Accessibilita/USB-HID-Module-Hat/README.md

# USB-HID-Module-Hat
Raspberry Pi Hat that adds RS485 communication to Raspberry Pi 5 for interfacting with USB and Bluetooth HID Devices
