Accessibilita/USB-HID-Module-Hat/PCB/USB-HID-Module-Hat/USB-HID-Module-Hat.kicad_pcb

## KiCad design PCB/USB-HID-Module-Hat/USB-HID-Module-Hat.kicad_pcb (2024-09-03)

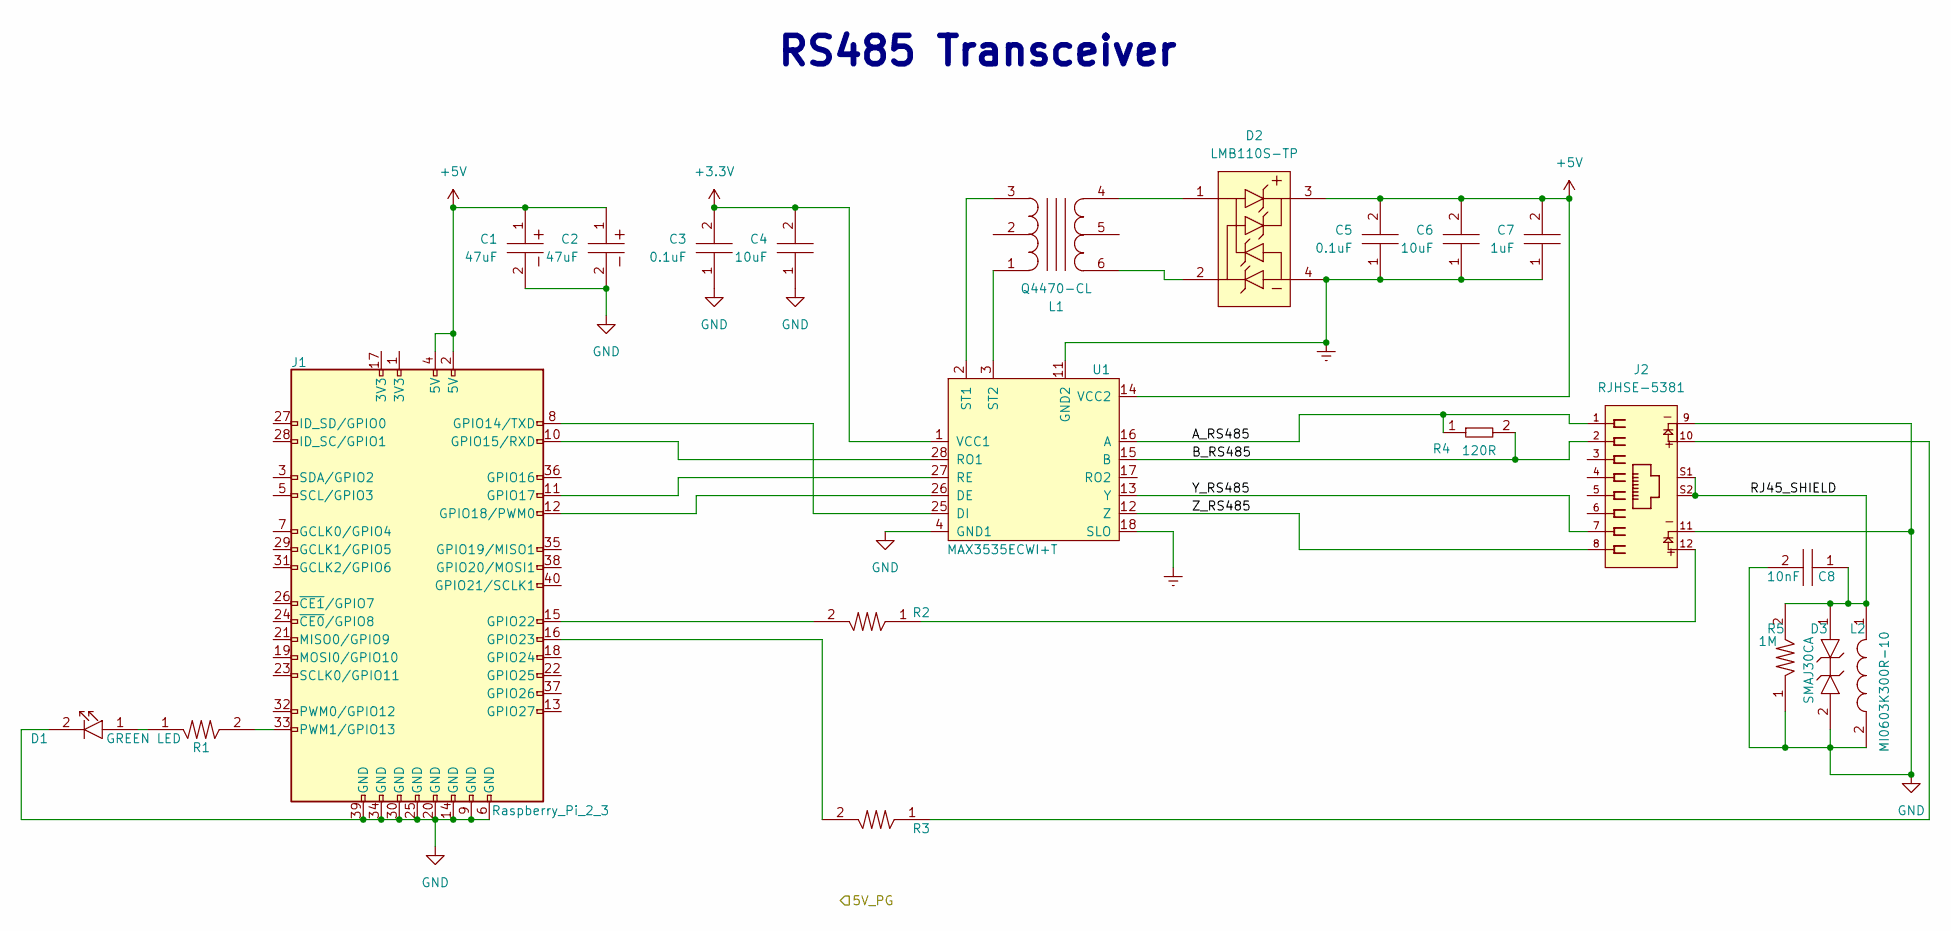
[picture p1: schematic RS485.kicad_sch]

Parts:
C1, C2: UCM1C470MCL1GS; Tolerance 20%; Voltage 16V; MFR# UCM1C470MCL1GS
C3, C5: CL10B104JB8NNNC; C0603; Tolerance 5%; Voltage 50V; MFR# CL10B104JB8NNNC
C4, C6: CGA5L3X5R1V106K160AB; C1206; Tolerance 10%; Voltage 35V; MFR# CGA5L3X5R1V106K160AB
C7: C1206C105K3RACAUTO; D_SOD-123; Tolerance 10%; Voltage 25V; MFR# C1206C105K3RACAUTO
C8: C0805C103KCRACAUTO; C0805; Tolerance 10%; Voltage 500V; MFR# C0805C103KCRACAUTO
D1: LTST-C194KGKT; LED0603; Tolerance *; Voltage 2.1V; MFR# LTST-C194KGKT
D2: LMB110S-TP; Tolerance *; Voltage 850 mV @ 500 mA; MFR# LMB110S-TP
D3: SMAJ30CA; Tolerance *; Voltage 30V Clamp; MFR# SMAJ30CA
J1: Raspberry_Pi_2_3; SULLINS_PPPC202LFBN-RC_RPi5
J2: RJHSE-5381; AMPHENOL_RJHSE-5381; Tolerance *; Voltage *; MFR# RJHSE-5381
L1: Q4470-CL; SO6_Q4470-CL_C-SIZE_COC; Tolerance *; Voltage 5V; MFR# Q4470-CL
L2: MI0603K300R-10; Tolerance *; Voltage *; MFR# MI0603K300R-10
R1, R2, R3: RC0603FR-07470RL; R0603; Tolerance 1%; Voltage *; MFR# RC0603FR-07470RL
R4: AC0402FR-07120RL; R0402; Tolerance 1%; Voltage *; MFR# AC0402FR-07120RL
R5: RC1206FR-071ML; R1206; Tolerance 1%; Voltage *; MFR# RC1206FR-071ML
U1: MAX3535ECWI+T; 21-0145_W28M&plus_9_MXM; Tolerance N/A; Voltage 3-5.5V; MFR# MAX3535ECWI+T

Connections:
+3.3V: C3.2, C4.2, U1.1 (VCC1); also elsewhere on the board
+5V: C1.1, C2.1, C5.2, C6.2, C7.2, D2.3, J1.2 (5V), J1.4 (5V), U1.14 (VCC2); also elsewhere on the board
/RS485/A_RS485: J2.1, R4.1, U1.16 (A)
/RS485/B_RS485: J2.2, R4.2, U1.15 (B)
/RS485/RJ45_SHIELD: C8.1, D3.1, J2.S1, J2.S2, L2.1, R5.2
/RS485/Y_RS485: J2.7, U1.13 (Y)
/RS485/Z_RS485: J2.8, U1.12 (Z)
Earth: C5.1, C6.1, C7.1, D2.4, U1.11 (GND2), U1.18 (SLO)
GND: C1.2, C2.2, C3.1, C4.1, C8.2, D1.2, D3.2, J1.6 (GND), J1.9 (GND), J1.14 (GND), J1.20 (GND), J1.25 (GND), J1.30 (GND), J1.34 (GND), J1.39 (GND), J2.9, J2.11, L2.2, R5.1, U1.4 (GND1); also elsewhere on the board
unnamed: D1.1, R1.1
unnamed: D2.1, L1.4
unnamed: D2.2, L1.6
unnamed: J1.8 (GPIO14/TXD), U1.25 (DI)
unnamed: J1.10 (GPIO15/RXD), U1.28 (RO1)
unnamed: J1.11 (GPIO17), U1.27 (RE)
unnamed: J1.12 (GPIO18/PWM0), U1.26 (DE)
unnamed: J1.15 (GPIO22), R2.2
unnamed: J1.16 (GPIO23), R3.2
unnamed: J1.33 (PWM1/GPIO13), R1.2
unnamed: J2.10, R3.1
unnamed: J2.12, R2.1
unnamed: L1.3, U1.2 (ST1)
unnamed: L1.1, U1.3 (ST2)

Notes on the sheet:
RS485 Transceiver

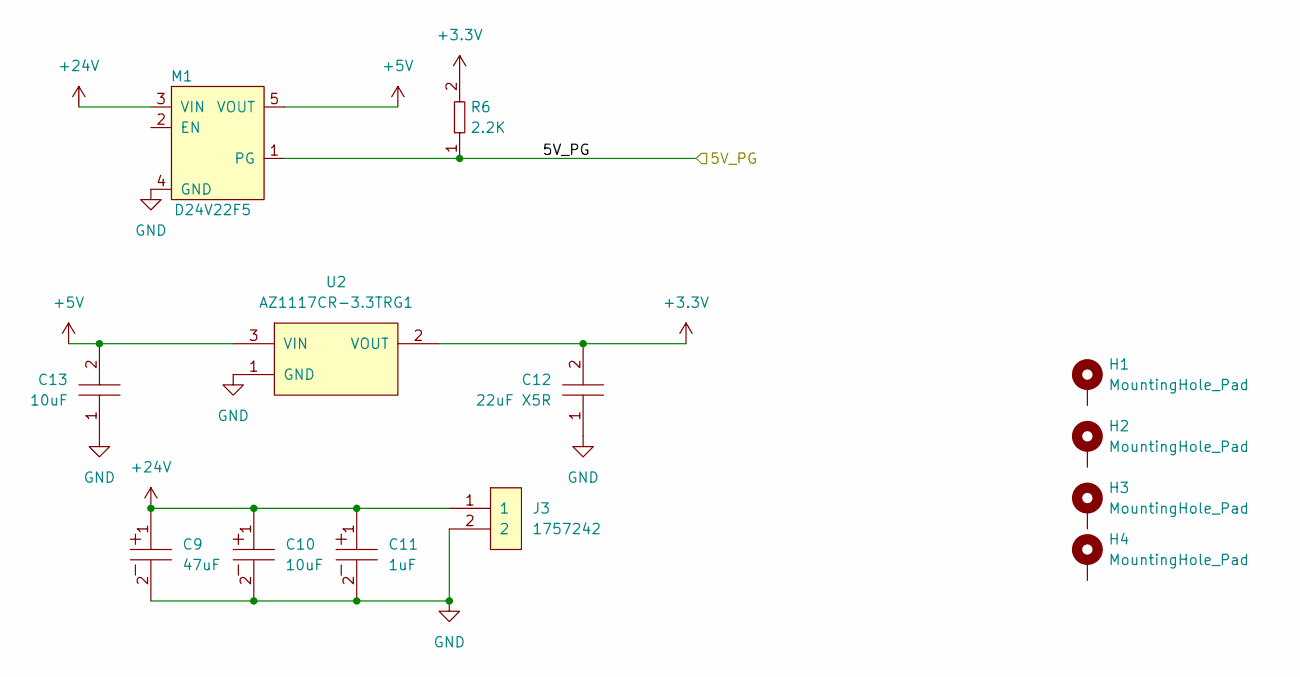
[picture p2: schematic Power.kicad_sch]

Parts:
C9: UUQ1H470MCL1GS; CP_Elec_8x10; Tolerance 20%; Voltage 50V; MFR# UUQ1H470MCL1GS
C10: UUQ1H100MCL1GB; CAP_UUQ_6P3X5P4_NCH; Tolerance 20%; Voltage 50V; MFR# UUQ1H100MCL1GB
C11: UUQ1H010MCL1GB; CAP_UUQ_4X5P4_NCH; Tolerance 20%; Voltage 50V; MFR# UUQ1H010MCL1GB
C12: GRM21BR61A226ME51L; C0805; Tolerance 20%; Voltage 10V; MFR# GRM21BR61A226ME51L
C13: GRT31CR61H106KE01L; C1206; Tolerance 10%; Voltage 50V; MFR# GRT31CR61H106KE01L
H1, H2, H3, H4: MountingHole_Pad; RPI_HAT_HOLE
J3: 1757242; PhoenixContact_MSTBA-G_02x5.08mm_Angled; Tolerance *; Voltage 300V; MFR# 1757242
M1: D24V22F5; D24V22F12; Tolerance N/A; Voltage 36V IN 5V OUT; MFR# D24V22F5
R6: RC0603FR-072K2L; R0603; Tolerance 1%; Voltage N/A; MFR# RC0603FR-072K2L
U2: AZ1117CR-3.3TRG1; SOT_89; Tolerance *; Voltage 15IN, 3V3 OUT; MFR# AZ1117CR-3.3TRG1

Connections:
+3.3V: C12.2, R6.2, U2.2 (VOUT); also elsewhere on the board
+5V: C13.2, M1.5 (VOUT), U2.3 (VIN); also elsewhere on the board
+24V: C9.1, C10.1, C11.1, J3.1, M1.3 (VIN)
/Power/5V_PG: M1.1 (PG), R6.1
GND: C9.2, C10.2, C11.2, C12.1, C13.1, J3.2, M1.4 (GND), U2.1 (GND); also elsewhere on the board

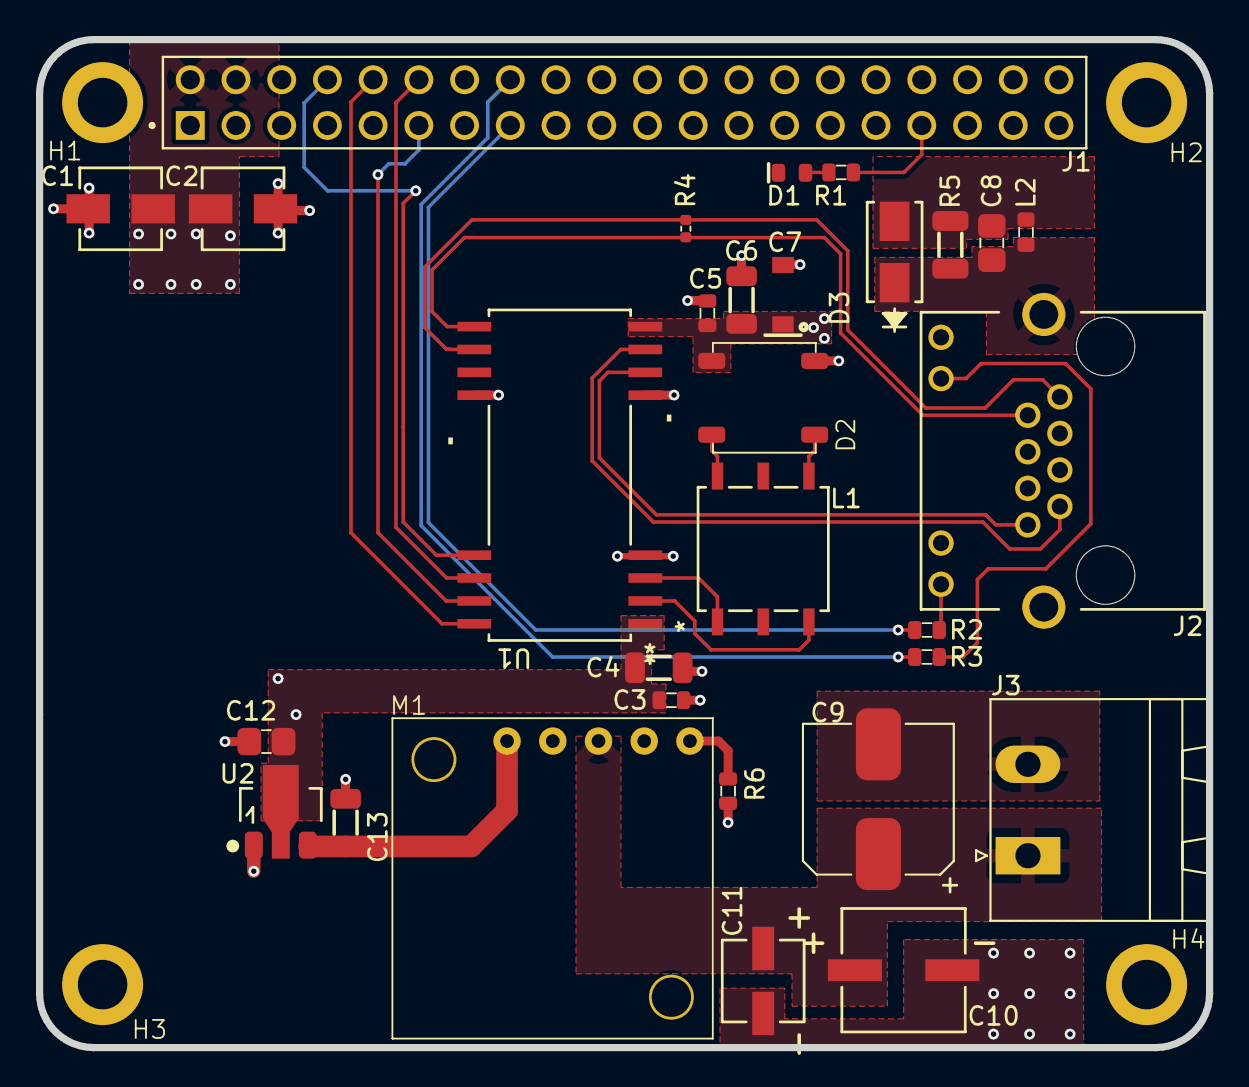
[picture p3: board USB-HID-Module-Hat.kicad_pcb from above]

Board: 4 copper layers, 65.0 x 56.0 mm, 34 parts (0 on the bottom side), 25 nets.
