Accessibilita/USB-HID-Module-Hat/(commit log)

2024-08-27 Schematic Capture
    Schematic capture complete !
    [USB-HID-Module-Hat.kicad_pcb, USB-HID-Module-Hat.kicad_sch]
2024-08-27 Revised Scheamtic
    Added schematic pages and added power schematic
    [Power.kicad_sch, RS485.kicad_sch, USB-HID-Module-Hat.kicad_pcb, USB-HID-Module-Hat.kicad_sch]
2024-08-27 PCB
    PCB layout 80% complete. Board shape defined. Components and connectors places !
    [Power.kicad_sch, RS485.kicad_sch, USB-HID-Module-Hat.kicad_pcb]
2024-09-03 First Pass at PCB
    PCB layout completed, pending design review.
    [USB-HID-Module-Hat.kicad_pcb]
